emaneric/Electronic-Christmas-Card/README.md

# Electronic-Christmas-Card
A christmas card made from a PCB with a LED display, buttons, and buzzer.
