emaneric/Electronic-Christmas-Card/PCB/Chirstmas-Card.kicad_pcb

## KiCad design PCB/Chirstmas-Card.kicad_pcb (2026-01-01)

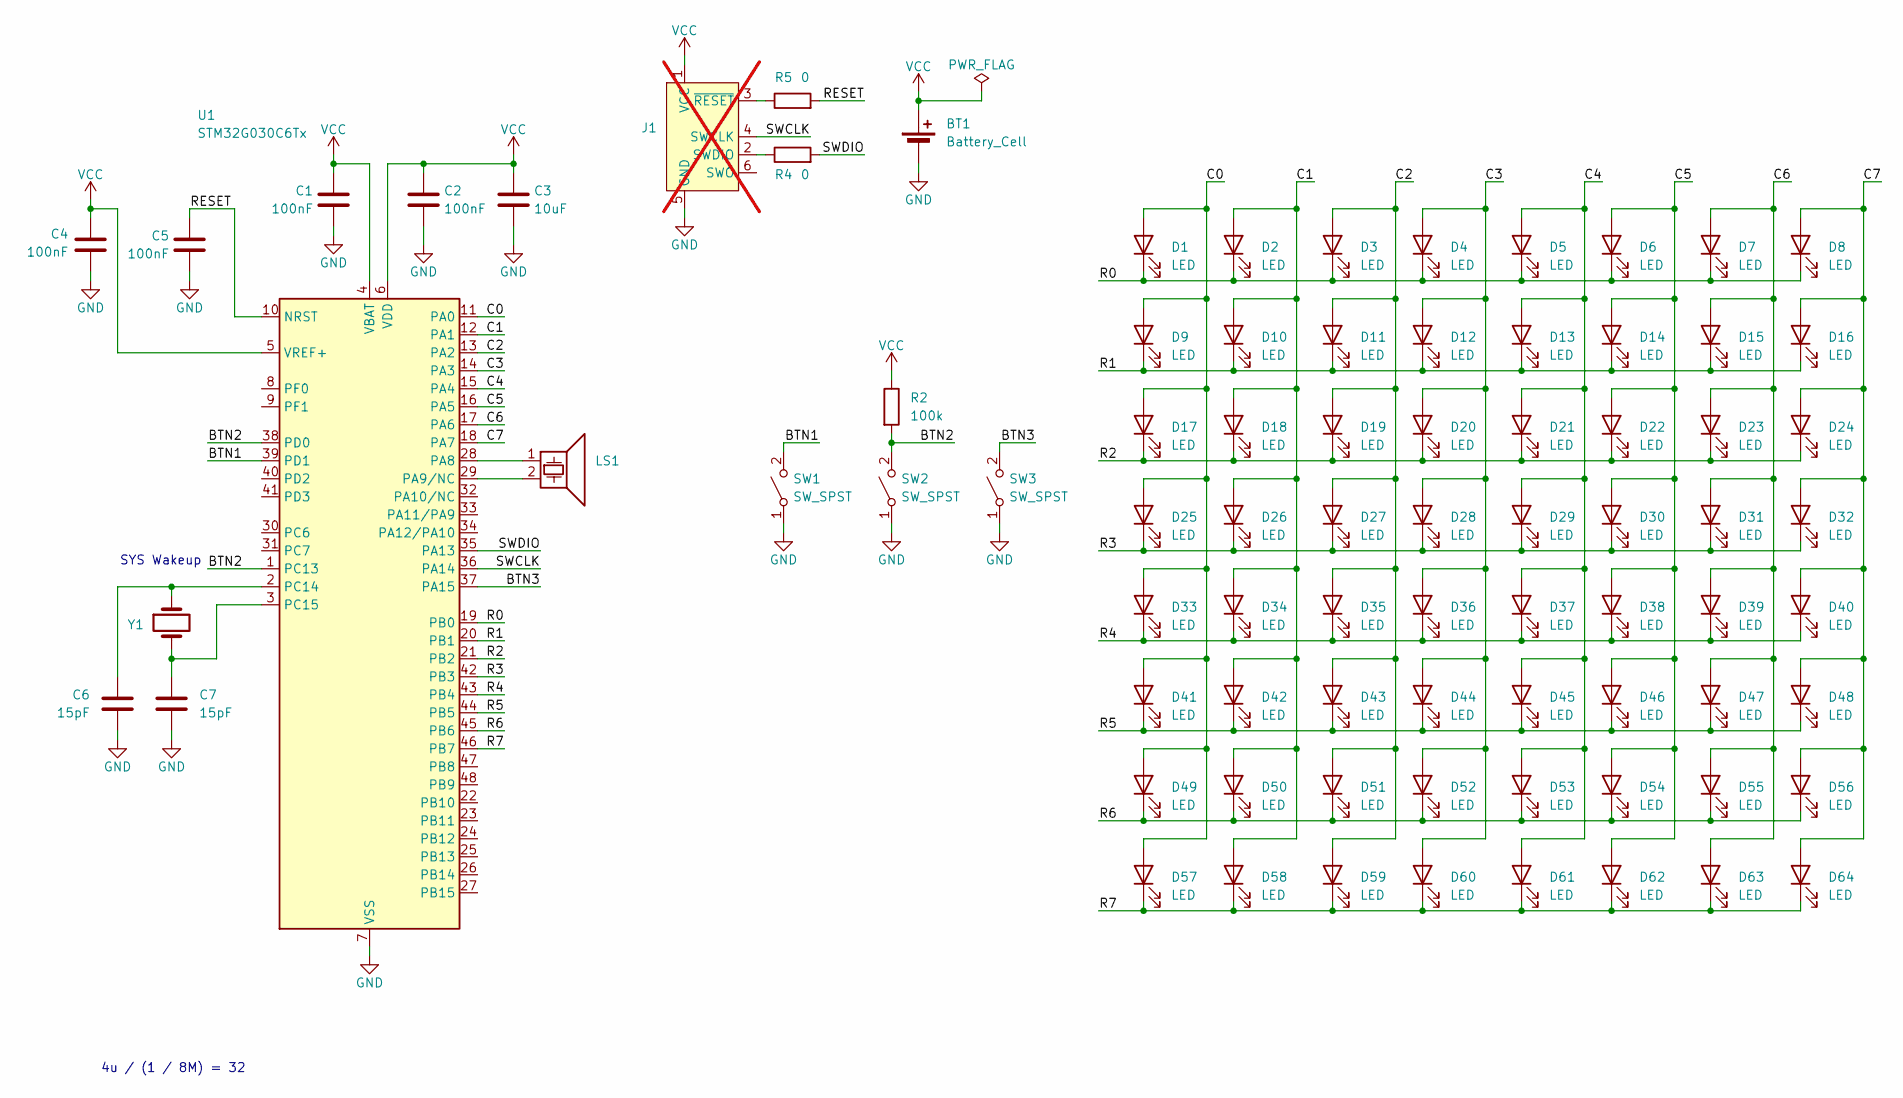
[picture p1: schematic Chirstmas-Card.kicad_sch]

Parts:
BT1: Battery_Cell; CR2032-BS-6-1; MPN CR2032-BS-6-1; JLC C70377
C1, C2, C4, C5: 100nF; C_0402_1005Metric; MPN CC0402KRX7R9BB104; JLC C131394
C3: 10uF; C_0603_1608Metric; MPN CL10A106MA8NRNC; JLC C96446
C6, C7: 15pF; C_0402_1005Metric; MPN 0402CG150J500NT; JLC C1548
D1, D2, D3, D4, D5, D6, D7, D8, D9, D10, D11, D12, D13, D14, D15, D16, D17, D18, D19, D20, D21, D22, D23, D24, D25, D26, D27, D28, D29, D30, D31, D32, D33, D34, D35, D36, D37, D38, D39, D40, D41, D42, D43, D44, D45, D46, D47, D48, D49, D50, D51, D52, D53, D54, D55, D56, D57, D58, D59, D60, D61, D62, D63, D64: LED; MHT151WDT; MPN MHT151WDT; JLC C401114
J1: Conn_ARM_SWD_TagConnect_TC2030-NL; Tag-Connect_TC2030-IDC-NL_2x03_P1.27mm_Vertical; not fitted
LS1: Speaker_Crystal; FUET-1230; MPN FUET-1230; JLC C391037
R2: 100k; R_0603_1608Metric; MPN 0402WGF1003TCE; JLC C25741
R4, R5: 0; R_0603_1608Metric; MPN 0402WGF1003TCE; JLC C25741
SW1, SW2, SW3: SW_SPST; KH-6X6X5H-STM; MPN KH-6X6X5H-STM; JLC C2837531
U1: STM32G030C6Tx; LQFP-48_7x7mm_P0.5mm; MPN STM32G030C6T6; JLC C529328
Y1: Crystal; Crystal_SMD_3215-2Pin_3.2x1.5mm; MPN Q13FC1350000400; JLC C32346

Connections:
/BTN1: SW1.2 (B), U1.39 (PD1)
/BTN2: R2.2, SW2.2 (B), U1.1 (PC13), U1.38 (PD0)
/BTN3: SW3.2 (B), U1.37 (PA15)
/C0: D1.2 (A), D9.2 (A), D17.2 (A), D25.2 (A), D33.2 (A), D41.2 (A), D49.2 (A), D57.2 (A), U1.11 (PA0)
/C1: D2.2 (A), D10.2 (A), D18.2 (A), D26.2 (A), D34.2 (A), D42.2 (A), D50.2 (A), D58.2 (A), U1.12 (PA1)
/C2: D3.2 (A), D11.2 (A), D19.2 (A), D27.2 (A), D35.2 (A), D43.2 (A), D51.2 (A), D59.2 (A), U1.13 (PA2)
/C3: D4.2 (A), D12.2 (A), D20.2 (A), D28.2 (A), D36.2 (A), D44.2 (A), D52.2 (A), D60.2 (A), U1.14 (PA3)
/C4: D5.2 (A), D13.2 (A), D21.2 (A), D29.2 (A), D37.2 (A), D45.2 (A), D53.2 (A), D61.2 (A), U1.15 (PA4)
/C5: D6.2 (A), D14.2 (A), D22.2 (A), D30.2 (A), D38.2 (A), D46.2 (A), D54.2 (A), D62.2 (A), U1.16 (PA5)
/C6: D7.2 (A), D15.2 (A), D23.2 (A), D31.2 (A), D39.2 (A), D47.2 (A), D55.2 (A), D63.2 (A), U1.17 (PA6)
/C7: D8.2 (A), D16.2 (A), D24.2 (A), D32.2 (A), D40.2 (A), D48.2 (A), D56.2 (A), D64.2 (A), U1.18 (PA7)
/R0: D1.1 (K), D2.1 (K), D3.1 (K), D4.1 (K), D5.1 (K), D6.1 (K), D7.1 (K), D8.1 (K), U1.19 (PB0)
/R1: D9.1 (K), D10.1 (K), D11.1 (K), D12.1 (K), D13.1 (K), D14.1 (K), D15.1 (K), D16.1 (K), U1.20 (PB1)
/R2: D17.1 (K), D18.1 (K), D19.1 (K), D20.1 (K), D21.1 (K), D22.1 (K), D23.1 (K), D24.1 (K), U1.21 (PB2)
/R3: D25.1 (K), D26.1 (K), D27.1 (K), D28.1 (K), D29.1 (K), D30.1 (K), D31.1 (K), D32.1 (K), U1.42 (PB3)
/R4: D33.1 (K), D34.1 (K), D35.1 (K), D36.1 (K), D37.1 (K), D38.1 (K), D39.1 (K), D40.1 (K), U1.43 (PB4)
/R5: D41.1 (K), D42.1 (K), D43.1 (K), D44.1 (K), D45.1 (K), D46.1 (K), D47.1 (K), D48.1 (K), U1.44 (PB5)
/R6: D49.1 (K), D50.1 (K), D51.1 (K), D52.1 (K), D53.1 (K), D54.1 (K), D55.1 (K), D56.1 (K), U1.45 (PB6)
/R7: D57.1 (K), D58.1 (K), D59.1 (K), D60.1 (K), D61.1 (K), D62.1 (K), D63.1 (K), D64.1 (K), U1.46 (PB7)
/RESET: C5.1, R5.2, U1.10 (NRST)
/SWCLK: J1.4 (SWCLK), U1.36 (PA14)
/SWDIO: R4.2, U1.35 (PA13)
GND: BT1.2 (-), C1.2, C2.2, C3.2, C4.2, C5.2, C6.2, C7.2, J1.5 (GND), SW1.1 (A), SW2.1 (A), SW3.1 (A), U1.7 (VSS)
unnamed: J1.2 (SWDIO), R4.1
unnamed: J1.3 (~RESET), R5.1
unnamed: LS1.1, U1.28 (PA8)
unnamed: LS1.2, U1.29 (PA9/NC)
unnamed: C6.1, U1.2 (PC14), Y1.1
unnamed: C7.1, U1.3 (PC15), Y1.2
VCC: BT1.1 (+), C1.1, C2.1, C3.1, C4.1, J1.1 (VCC), R2.1, U1.4 (VBAT), U1.5 (VREF+), U1.6 (VDD)

Notes on the sheet:
SYS Wakeup
4u / (1 / 8M) = 32

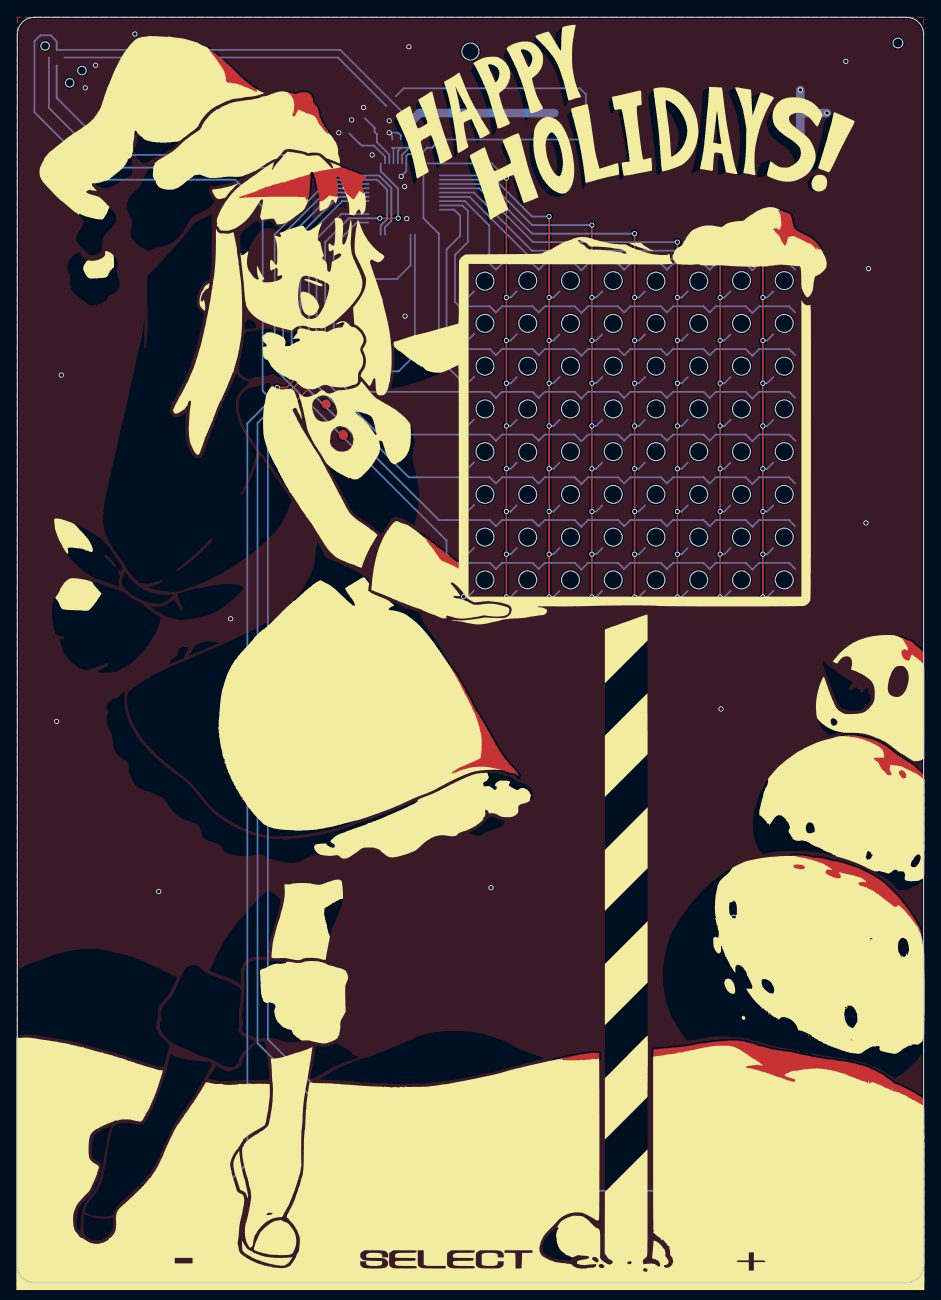
[picture p2: board Chirstmas-Card.kicad_pcb from above]

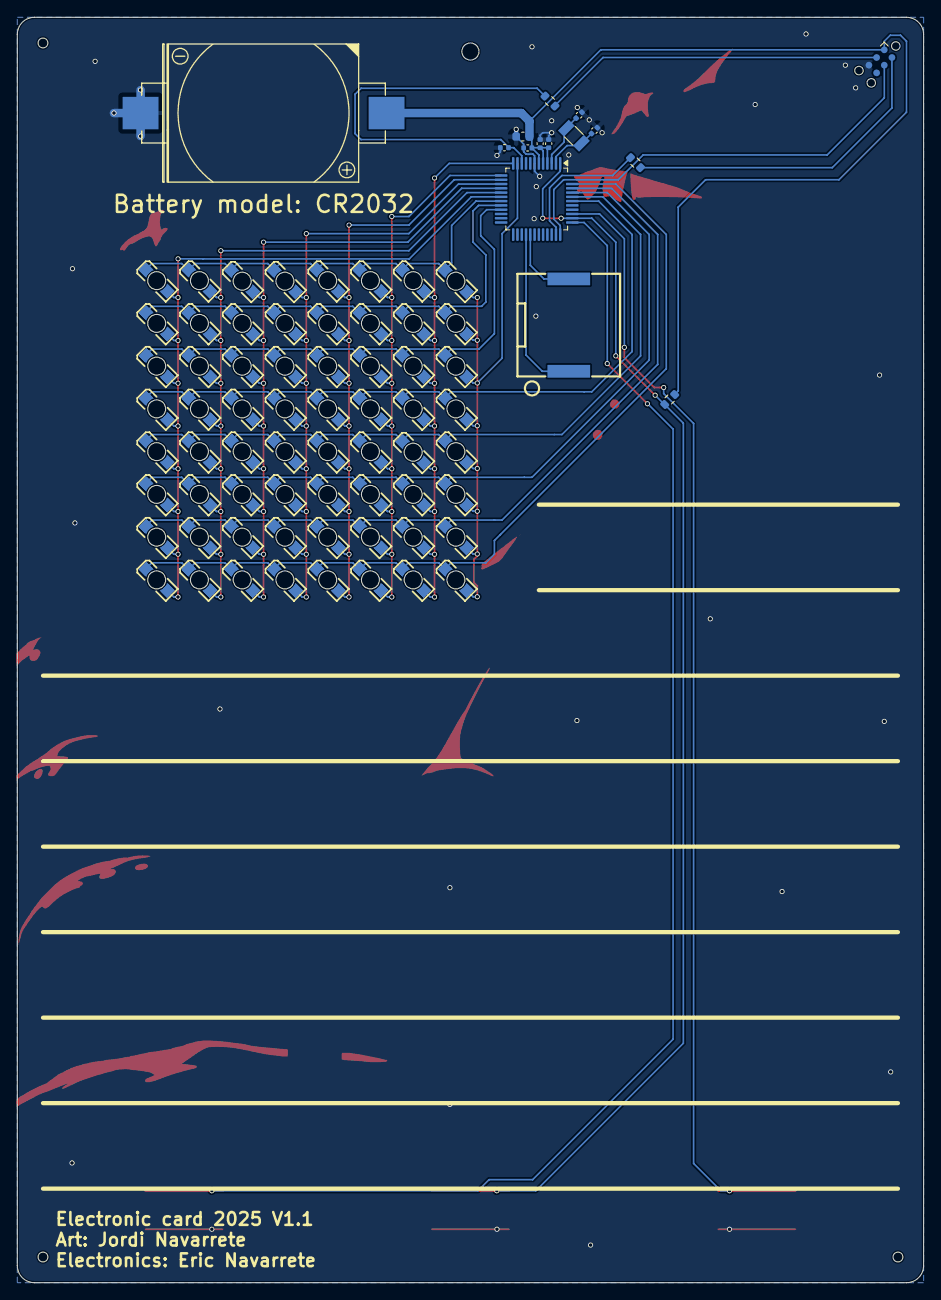
[picture p3: board Chirstmas-Card.kicad_pcb from below]

Board: 2 copper layers, 106.0 x 148.0 mm, 83 parts (79 on the bottom side), 30 nets.

Other parts of the board:
Art: Val**; jordi-christmas-girl-V2
