emaneric/Electronic-Christmas-Card/christmas-card-code/Core/Src/main.c

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
/* Includes ------------------------------------------------------------------*/
#include "main.h"

/* USER CODE BEGIN Includes */
#include "buzzer.h"
#include "cmsis_gcc.h"
#include "display.h"
#include "stm32g0xx_hal.h"
#include "stm32g0xx_hal_def.h"
#include "stm32g0xx_hal_dma.h"
#include <stdio.h>
#include <string.h>
/* USER CODE END Includes */

/* USER CODE BEGIN PD */
#define NOTE_B0 31
#define NOTE_C1 33
#define NOTE_CS1 35
#define NOTE_D1 37
#define NOTE_DS1 39
#define NOTE_E1 41
#define NOTE_F1 44
#define NOTE_FS1 46
#define NOTE_G1 49
#define NOTE_GS1 52
#define NOTE_A1 55
#define NOTE_AS1 58
#define NOTE_B1 62
#define NOTE_C2 65
#define NOTE_CS2 69
#define NOTE_D2 73
#define NOTE_DS2 78
#define NOTE_E2 82
#define NOTE_F2 87
#define NOTE_FS2 93
#define NOTE_G2 98
#define NOTE_GS2 104
#define NOTE_A2 110
#define NOTE_AS2 117
#define NOTE_B2 123
#define NOTE_C3 131
#define NOTE_CS3 139
#define NOTE_D3 147
#define NOTE_DS3 156
#define NOTE_E3 165
#define NOTE_F3 175
#define NOTE_FS3 185
#define NOTE_G3 196
#define NOTE_GS3 208
#define NOTE_A3 220
#define NOTE_AS3 233
#define NOTE_B3 247
#define NOTE_C4 262
#define NOTE_CS4 277
#define NOTE_D4 294
#define NOTE_DS4 311
#define NOTE_E4 330
#define NOTE_F4 349
#define NOTE_FS4 370
#define NOTE_G4 392
#define NOTE_GS4 415
#define NOTE_A4 440
#define NOTE_AS4 466
#define NOTE_B4 494
#define NOTE_C5 523
#define NOTE_CS5 554
#define NOTE_D5 587
#define NOTE_DS5 622
#define NOTE_E5 659
#define NOTE_F5 698
#define NOTE_FS5 740
#define NOTE_G5 784
#define NOTE_GS5 831
#define NOTE_A5 880
#define NOTE_AS5 932
#define NOTE_B5 988
#define NOTE_C6 1047
#define NOTE_CS6 1109
#define NOTE_D6 1175
#define NOTE_DS6 1245
#define NOTE_E6 1319
#define NOTE_F6 1397
#define NOTE_FS6 1480
#define NOTE_G6 1568
#define NOTE_GS6 1661
#define NOTE_A6 1760
#define NOTE_AS6 1865
#define NOTE_B6 1976
#define NOTE_C7 2093
#define NOTE_CS7 2217
#define NOTE_D7 2349
#define NOTE_DS7 2489
#define NOTE_E7 2637
#define NOTE_F7 2794
#define NOTE_FS7 2960
#define NOTE_G7 3136
#define NOTE_GS7 3322
#define NOTE_A7 3520
#define NOTE_AS7 3729
#define NOTE_B7 3951
#define NOTE_C8 4186
#define NOTE_CS8 4435
#define NOTE_D8 4699
#define NOTE_DS8 4978

// #define noteSpace 24
// #define noteSpace2 12
// #define _16thNote 110
// #define dotted16th 165
// #define _8thNote 220
// #define dotted8th 330
#define _4thNote 440
#define dotted4th 660
#define halfNote 880
#define dottedHalf 1320
#define wholeNote 1760

#define noteSpace 12
#define noteSpace2 6
#define _16thNote 55
#define dotted16th 83
#define _8thNote 110
#define dotted8th 165
/* USER CODE END PD */

ADC_HandleTypeDef hadc1;

RTC_HandleTypeDef hrtc;

TIM_HandleTypeDef htim1;
TIM_HandleTypeDef htim3;
TIM_HandleTypeDef htim14;
TIM_HandleTypeDef htim16;
DMA_HandleTypeDef hdma_tim3_ch1;
DMA_HandleTypeDef hdma_tim3_ch2;

void SystemClock_Config(void);
static void MX_GPIO_Init(void);
static void MX_DMA_Init(void);
static void MX_RTC_Init(void);
static void MX_ADC1_Init(void);
static void MX_TIM1_Init(void);
static void MX_TIM3_Init(void);
static void MX_TIM14_Init(void);
static void MX_TIM16_Init(void);
/* USER CODE BEGIN PFP */
void generate_BSRR_array(uint8_t pixel_values[8],
                         volatile uint32_t BSRR_row_array[64],
                         volatile uint32_t BSRR_column_array[64]);
/* USER CODE END PFP */

/* USER CODE BEGIN 0 */

volatile uint8_t pixel_index = 0;
volatile uint32_t test_row_array[64] = {0};
volatile uint32_t test_column_array[64] = {0};

// Easy way to see if data being processed properly
static uint8_t test_image1[8] = {
    0xFF, 0x0, 0xFF, 0x0, 0xFF, 0x0, 0xFF, 0x0,
};

static uint8_t test_image2[8] = {
    0b10000000, 0x0, 0x0, 0x0, 0x0, 0x0, 0x0, 0x0,
};

static uint8_t test_image3[8] = {
    0xFF, 0x0, 0x0, 0x0, 0x0, 0x0, 0x0, 0x0,
};

static uint8_t test_image4[8] = {
    0xFF, 0xFF, 0xFF, 0xFF, 0xFF, 0xFF, 0xFF, 0xFF,
};

display_HandleTypeDef display;
buzzer_HandleTypeDef buzzer;

/* USER CODE END 0 */

/**
  * @brief  The application entry point.
  * @retval int
  */
int main(void)
{

  /* MCU Configuration--------------------------------------------------------*/

  /* Reset of all peripherals, Initializes the Flash interface and the Systick. */
  HAL_Init();

  /* Configure the system clock */
  SystemClock_Config();

  /* Initialize all configured peripherals */
  MX_GPIO_Init();
  MX_DMA_Init();
  MX_RTC_Init();
  MX_ADC1_Init();
  MX_TIM1_Init();
  MX_TIM3_Init();
  MX_TIM14_Init();
  MX_TIM16_Init();
  /* USER CODE BEGIN 2 */

  // Always calibrate ADC first
  HAL_ADCEx_Calibration_Start(&hadc1);

  // Start the conversion sequence
  HAL_ADC_Start(&hadc1);
  HAL_ADC_PollForConversion(&hadc1, 0xFFFF);
  uint32_t vrefint_raw = HAL_ADC_GetValue(&hadc1);
  /*
   * This macro calculates the vdda voltage (as a uint32_t representing the
   * voltage in milliVolts) using the vref internal raw adc value, and the
   * internal calibration value in ROM
   */
  uint32_t vdda_voltage =
      __HAL_ADC_CALC_VREFANALOG_VOLTAGE(vrefint_raw, ADC_RESOLUTION_12B);
  uint32_t frame_start_ms = 0;
  uint32_t frame_end_ms = 0;
  uint32_t frame_duration_ms = 0;
  __NOP();

  generate_BSRR_array(test_image1, test_row_array, test_column_array);

  /*
  Timer 3 configured to trigger every 260μs
  It takes 260 * 64 = 16.64ms to update a single frame
  Frame rate is: 1s / 16.64ms = 60.09.
  */

  uint8_t error = 0;

  if (HAL_TIM_Base_Start_IT(&htim3) != HAL_OK) {
    error = 1;
  }

  if (HAL_DMA_Start_IT(&hdma_tim3_ch1, (uint32_t)test_row_array,
                    (uint32_t)&GPIOB->BSRR, 64) != HAL_OK) {
    error = 1;
  }

  if (HAL_DMA_Start_IT(&hdma_tim3_ch2, (uint32_t)test_column_array,
                    (uint32_t)&GPIOA->BSRR, 64) != HAL_OK) {
    error = 1;
  }

  __HAL_TIM_ENABLE_DMA(&htim3, TIM_DMA_CC1);
  __HAL_TIM_ENABLE_DMA(&htim3, TIM_DMA_CC2);

  if (HAL_TIM_OC_Start(&htim3, TIM_CHANNEL_1) != HAL_OK){
    error = 1;
  }
  if (HAL_TIM_OC_Start(&htim3, TIM_CHANNEL_2) != HAL_OK){
    error = 1;
  }

  if (error != 0){
    __NOP();
  }
  __NOP();

  // Force a software DMA request for Channel 1
  // HAL_TIM_GenerateEvent(&htim3, TIM_EVENTSOURCE_CC1);
  //__NOP();

  /* USER CODE END 2 */

  /* Infinite loop */
  /* USER CODE BEGIN WHILE */
  while (1) {

    // Record the start and end tick value to calculate how long a single frame
    // was displayed
    if (pixel_index == 0) {
      frame_start_ms = HAL_GetTick();
    }

    else if (pixel_index == 63) {
      frame_end_ms = HAL_GetTick();
      frame_duration_ms = frame_end_ms - frame_start_ms;
      __NOP();
    }

    __NOP();

    //	  GPIOB->BSRR = test_row_array[pixel_index];
    //	  GPIOA->BSRR = test_column_array[pixel_index];
    //	  //HAL_Delay(1);
    //
    //	  pixel_index++;
    //
    //	  if (pixel_index > 63){
    //		  pixel_index = 0;
    //	  }
    // HAL_Delay(1000);

    /* USER CODE END WHILE */

    /* USER CODE BEGIN 3 */
  }
  /* USER CODE END 3 */
}

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
/* USER CODE BEGIN 4 */

void HAL_TIM_PeriodElapsedCallback(TIM_HandleTypeDef *htim) {

  __NOP();

  if (htim == buzzer.interrupt_timer) {
    // buzzer_interrupt(&buzzer);
  }

  else if (htim == &htim3) {

    __NOP();
    // GPIOB->BSRR = test_row_array[pixel_index];
    // GPIOA->BSRR = test_column_array[pixel_index];
    // pixel_index++;

    // if (pixel_index > 63) {
    //   pixel_index = 0;
    // }
  }
}

//void HAL_DMA_XFER_ERROR_CB_ID


// Take an array of pixel values in the form uint8_t pixel_values[8]
// convert it to two arrays of data to be sent to the BSRR registers the form
// uint8_t data[64]
void generate_BSRR_array(uint8_t pixel_values[8],
                         volatile uint32_t BSRR_row_array[64],
                         volatile uint32_t BSRR_column_array[64]) {

  // Rows are the LED cathodes on port B.
  // Row 0 is PB0, Row 7 is PB7
  // Columns are LED anodes on port A
  // Column 0 is PB0, Column 7 is PB7
  // MSB of pixel value corresponds to column 0

  uint8_t input_column_index = 0; // keeps track of the current bit in the row
  uint8_t input_row_index = 0;    // Keeps track of the current row

  // Calculate the BSRR values for every pixel
  for (uint8_t pixel_index = 0; pixel_index < 64; pixel_index++) {
    // Check the value of the pixel we are interested in
    // if ((pixel_values[input_row_index] >> input_column_index) & 1){
    if ((pixel_values[input_row_index] >> (7 - input_column_index)) &
        1) { // reverse the order so the MSB of the pixel array coresponds to
             // column 0

      // Calculate the BSRR registers for row and column in order to set the
      // pixel high Turn off the row pin we want and turn on all other row pins
      // Turn on the column pin we want and turn off all other columns.

      uint32_t BSRR_row = 0x0000FFFF; // All row pins start set

      // Reset the pin we want
      BSRR_row &= ~(1 << input_row_index);     // clear chosen row in lower half
      BSRR_row |= 1 << (input_row_index + 16); // set reset bit in upper half
      BSRR_row_array[pixel_index] = BSRR_row;

      uint32_t BSRR_column = 0xFFFF0000; // All column pins start reset

      // Set the pin we want
      BSRR_column &= ~(1 << (input_column_index + 16));
      BSRR_column |= 1 << (input_column_index);
      BSRR_column_array[pixel_index] = BSRR_column;
    }

    else {
      // Calculate the BSRR registers for row and column in order to set the
      // pixel low Turn off both row and column pins
      BSRR_row_array[pixel_index] = 0xFFFF00;
      BSRR_column_array[pixel_index] = 0xFFFF00;
    }

    input_column_index++;

    // Once every bit in the row is processed, go to the next row and start from
    // bit 0 again
    if (input_column_index > 7) {
      input_column_index = 0;
      input_row_index++;
    }
  }
}

/* USER CODE END 4 */
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
