emaneric/Electronic-Christmas-Card/christmas-card-code/christmas-card-code.ioc

Mcu.UserName=STM32G030C6Tx
PA0.GPIO_Label=C0
PA0.Signal=GPIO_Output
PA1.GPIO_Label=C1
PA1.Signal=GPIO_Output
PA13.Signal=SYS_SWDIO
PA14-BOOT0.Signal=SYS_SWCLK
PA15.GPIO_Label=BTN3
PA15.Signal=GPIO_Input
PA2.GPIO_Label=C2
PA2.Signal=GPIO_Output
PA3.GPIO_Label=C3
PA3.Signal=GPIO_Output
PA4.GPIO_Label=C4
PA4.Signal=GPIO_Output
PA5.GPIO_Label=C5
PA5.Signal=GPIO_Output
PA6.GPIO_Label=C6
PA6.Signal=GPIO_Output
PA7.GPIO_Label=C7
PA7.Signal=GPIO_Output
PA8.Signal=S_TIM1_CH1
PA9.Signal=S_TIM1_CH2
PB0.GPIO_Label=R0
PB0.Signal=GPIO_Output
PB1.GPIO_Label=R1
PB1.Signal=GPIO_Output
PB2.GPIO_Label=R2
PB2.Signal=GPIO_Output
PB3.GPIO_Label=R3
PB3.Signal=GPIO_Output
PB4.GPIO_Label=R4
PB4.Signal=GPIO_Output
PB5.GPIO_Label=R5
PB5.Signal=GPIO_Output
PB6.GPIO_Label=R6
PB6.Signal=GPIO_Output
PB7.GPIO_Label=R7
PB7.Signal=GPIO_Output
PC13.Signal=SYS_WKUP2
PD0.GPIO_Label=BTN2
PD0.Signal=GPIO_Input
PD1.GPIO_Label=BTN1
PD1.Signal=GPIO_Input
