emaneric/Electronic-Christmas-Card/christmas-card-code/Core/Inc/main.h

#define C0_Pin GPIO_PIN_0
#define C0_GPIO_Port GPIOA
#define C1_Pin GPIO_PIN_1
#define C1_GPIO_Port GPIOA
#define C2_Pin GPIO_PIN_2
#define C2_GPIO_Port GPIOA
#define C3_Pin GPIO_PIN_3
#define C3_GPIO_Port GPIOA
#define C4_Pin GPIO_PIN_4
#define C4_GPIO_Port GPIOA
#define C5_Pin GPIO_PIN_5
#define C5_GPIO_Port GPIOA
#define C6_Pin GPIO_PIN_6
#define C6_GPIO_Port GPIOA
#define C7_Pin GPIO_PIN_7
#define C7_GPIO_Port GPIOA
#define R0_Pin GPIO_PIN_0
#define R0_GPIO_Port GPIOB
#define R1_Pin GPIO_PIN_1
#define R1_GPIO_Port GPIOB
#define R2_Pin GPIO_PIN_2
#define R2_GPIO_Port GPIOB
#define BTN3_Pin GPIO_PIN_15
#define BTN3_GPIO_Port GPIOA
#define BTN2_Pin GPIO_PIN_0
#define BTN2_GPIO_Port GPIOD
#define BTN1_Pin GPIO_PIN_1
#define BTN1_GPIO_Port GPIOD
#define R3_Pin GPIO_PIN_3
#define R3_GPIO_Port GPIOB
#define R4_Pin GPIO_PIN_4
#define R4_GPIO_Port GPIOB
#define R5_Pin GPIO_PIN_5
#define R5_GPIO_Port GPIOB
#define R6_Pin GPIO_PIN_6
#define R6_GPIO_Port GPIOB
#define R7_Pin GPIO_PIN_7
#define R7_GPIO_Port GPIOB
