emaneric/Electronic-Christmas-Card/(commit log)

2024-11-03 Initial Commit, work in progress
    [Chirstmas-Card-B_Cu.gbr, Chirstmas-Card-B_Mask.gbr, Chirstmas-Card-B_Paste.gbr, Chirstmas-Card-B_Silkscreen.gbr, Chirstmas-Card-Edge_Cuts.gbr, Chirstmas-Card-F_Cu.gbr, Chirstmas-Card-F_Mask.gbr, Chirstmas-Card-F_Paste.gbr]
2024-12-12 Added initial buzzer functionality
    [Chirstmas-Card-B_Cu.gbr, Chirstmas-Card-B_Mask.gbr, Chirstmas-Card-B_Paste.gbr, Chirstmas-Card-B_Silkscreen.gbr, Chirstmas-Card-Edge_Cuts.gbr, Chirstmas-Card-F_Cu.gbr, Chirstmas-Card-F_Mask.gbr, Chirstmas-Card-F_Paste.gbr]
2026-01-01 -migration to new cube mx version and cmake toolchain
    [Chirstmas-Card-B_Cu.gbl, Chirstmas-Card-B_Cu.gbr, Chirstmas-Card-B_Mask.gbr, Chirstmas-Card-B_Mask.gbs, Chirstmas-Card-B_Paste.gbp, Chirstmas-Card-B_Paste.gbr, Chirstmas-Card-B_Silkscreen.gbo, Chirstmas-Card-B_Silkscreen.gbr]
2026-01-01 -modified timer values to give a 60fps framerate
    [Chirstmas-Card-B_Cu.gbr, Chirstmas-Card-B_Mask.gbr, Chirstmas-Card-B_Paste.gbr, Chirstmas-Card-B_Silkscreen.gbr, Chirstmas-Card-Edge_Cuts.gbr, Chirstmas-Card-F_Cu.gbr, Chirstmas-Card-F_Mask.gbr, Chirstmas-Card-F_Paste.gbr]
2026-01-16 -Unsuccesful attempt to trigger DMA transfer from timer
